arber333/TeensyVCU/Schematic_Mini-E T4 VCU V2_2023-12-14.pdf

# Teensy 4.1 VBat 49 3.3V 50

## dsn mini 360

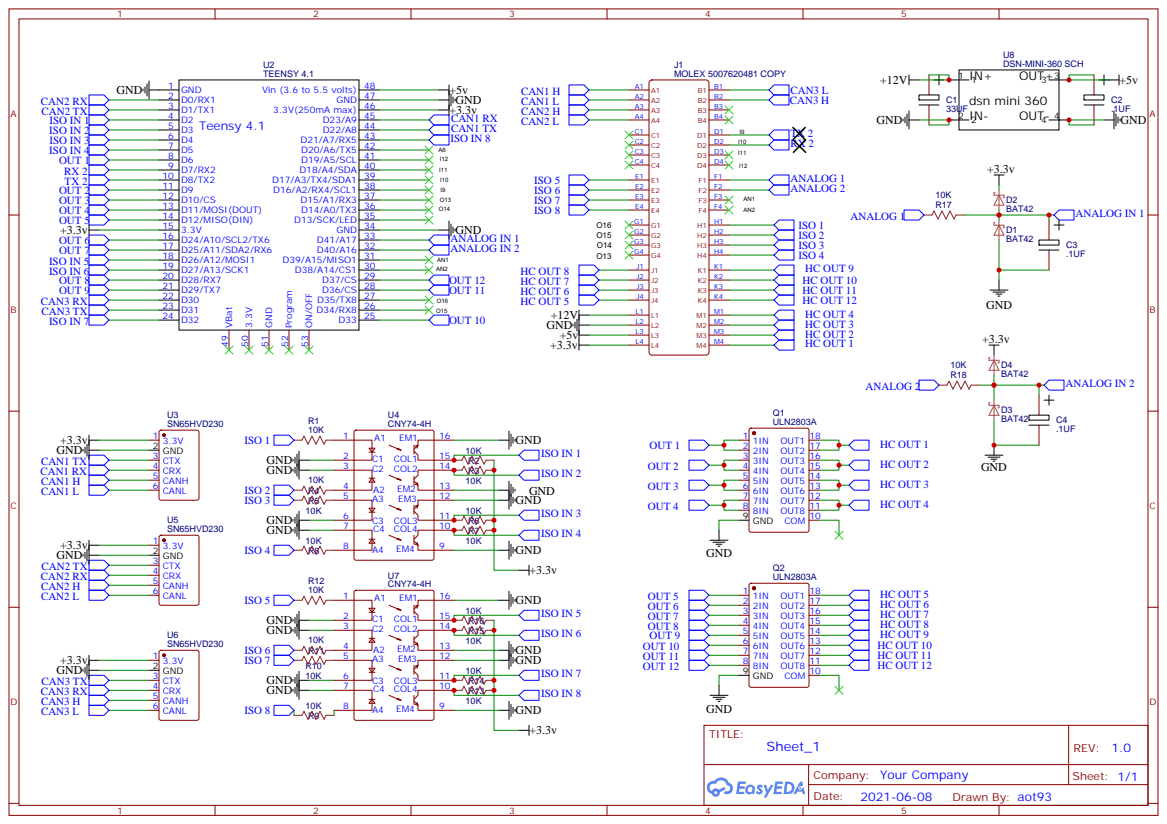
[picture p4: page 1]
