arber333/TeensyVCU/Schematic_Mini-E-T4-VCU-V2_2025-05-03.pdf

# Teensy 4.1 VBat 49 3.3V 50

## dsn mini 360

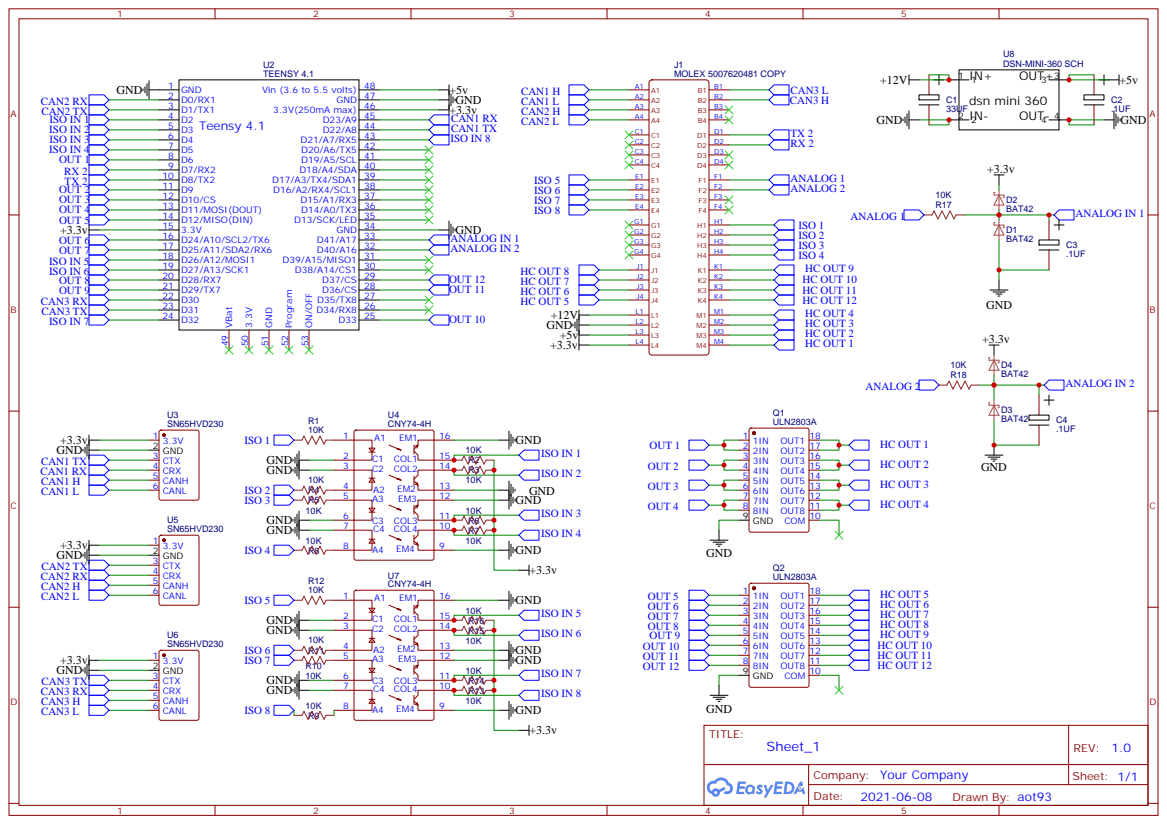
[picture p5: page 1]
