arber333/TeensyVCU/(list of files, drawings)

Other design files:
Teensy shield_V2_2.pcb
